bneedhamia/glockenspiel/MechanicalNotes.odp

## Mechanical notes for the Robotic Glockenspiel

Brad Needham

2015

## Lighted pushbutton order

Green

On

/Off

Red

Play

/Pause

Yellow

Skip

back

Yellow

Skip

forward

White

Shuffle

/Sequential

View from outside of box (pushbutton side)

## Lighted pushbutton / connector wiring

Button Common.

Blue/White

wire

Button Common.

Blue/White

wire

Button Normally-Open.

Blue

wire

Button Normally-Open.

Blue

wire

Back of Button

C

–

NO

NC

LED Cathode.

Orange/White

wire

+

LED Anode.

Orange

wire

LED Anode.

Orange

wire

4

3

2

1

LED Cathode.

Orange/White

wire

Connector pin numbers

Note: wire colors are from the 4-wire cable I used;

your wire colors/markings will be different.
