bneedhamia/glockenspiel/BillOfMaterials.ods

Bill Of Materials for Arduino-Controlled, 19-chime Glockenspiel
Count | Name | Supplier | Part Number | Cost each | Total | Url | Notes
1 | Arduino Mega 2650 R3 | Sparkfun | DEV-11061 | $45.95 | $45.95 | https://www.sparkfun.com/products/11061
1 | Wall Adapter Power Supply - 9VDC 650mA | Sparkfun | TOL-00298 | $5.95 | $5.95 | https://www.sparkfun.com/products/298 | 9v is important for solenoid power.
1 | Sparkfun Wifi Shield CC3000 | Sparkfun | DEV-12071 | $39.95 | $39.95 | https://www.sparkfun.com/products/12071 | Could use a MicroSD shield instead, if you don't want to use the network.
1 | Sparkfun TransmogriShield | Sparkfun | DEV-11469 | $14.95 | $14.95 | https://www.sparkfun.com/products/11469 | Interfaces between Mega and Shield
5 | Metal Pushbutton – Momentary, 16mm | Sparkfun | COM-11970, 11966,11968,11969 | $4.95 | $24.75 | https://www.sparkfun.com/products/11970 | Lighted pushbuttons: 1 green, 1 red, 2 yellow, 1 white. For start/stop, play/pause, forward 1 track, back 1 track, and shuffle tracks
3 | Breadboard - Full-Size (Bare) | Sparkfun | PRT-12615 | $5.95 | $17.85 | https://www.sparkfun.com/products/12615 | 2 for the solenoid circuit; 1 for the buttons circuit
1 | Hookup wire, solid, 22Awg, white | Sparkfun | PRT-08026 | $2.50 | $2.50 | https://www.sparkfun.com/products/8026 | Signal wires
1 | Hookup wire, solid, 22Awg, black | Sparkfun | PRT-08022 | $2.50 | $2.50 | https://www.sparkfun.com/products/8022 | Ground wires
1 | Hookup wire, solid, 22Awg, red | Sparkfun | PRT-08023 | $2.50 | $2.50 | https://www.sparkfun.com/products/8023 | Power wires
1 | Hookup wire, solid, 22Awg, yellow | Sparkfun | PRT-08024 | $2.50 | $2.50 | https://www.sparkfun.com/products/8024 | Solenoid power wires. I normally use green
19 | Solenoid, small, 5V, 4.5Ohm | Sparkfun | ZHO-0420S-05A4.5 | $4.95 | $94.05 | https://www.sparkfun.com/products/11015 | one per chime
3 | Break-away headers – straight, 40 pins | Sparkfun | PRT-00116 | $1.50 | $4.50 | https://www.sparkfun.com/products/116 | 2 x 38 for the solenoid connectors; 4 x 5 for the button connectors
1 | Standoffs Plastic (4-40; 3/8"; 10 pack) | Sparkfun | PRT-10461 | $2.95 | $2.95 | https://www.sparkfun.com/products/10461 | holds the circuit boards off the plywood box base.
3 | Metal EMT Conduit, 1/2", 10' | Lowes | 72711 | $2.48 | $7.44 | http://www.lowes.com/pd_72711-1792-101543_0__?productId=3129551 | The chimes. 3 is a generous estimate. You may be able to do it with only 2.
2 | dowel, round, poplar, 1/4" x 4' | Lowes | 19375 | $0.55 | $1.10 | http://www.lowes.com/pd_19375-261-436500_0__?Ntt=19375&UserSearch=19375&productId=3040764&rpp=16 | 1.75" pins x 2 per chime x 19 chimes
1 | cable ties, 8", 100 count | Lowes | 76329 | $7.15 | $7.15 | http://www.lowes.com/pd_76329-47120-SGY-CT23_0__?productId=50005730 | To tie down the solenoids and manage the solenoid wires. Need only about 25
5 | wood, pine, 3/4" x 1.5" x 4ft (1x2x4ft) | Lowes | 1204 | $2.48 | $12.40 | http://www.lowes.com/pd_1204-99899-83704_0__?productId=3602732&Ntt=wood+.75-in+x+1.5-in+x+4-ft&pl=1&facetInfo= | For the harp of the glockenspiel. 6Ft lengths might cause less waste
2 | wood, pine, 1" x 6" x 6ft | Lowes | ? | $2.48 | $4.96 | ? | sides of the box
2 | Birch Plywood (Common: 1/2-in x 2-ft x 4-ft; Actual: .45-in x 47.92-in x 23.92-in) | Lowes | 6200 | $11.97 | $23.94 | http://www.lowes.com/pd_6200-99899-1503304_0__?Ntt=6200 | Top and bottom of the box
1 | Birch Plywood (Common: 1/4-in x 2-ft x 4-ft; Actual: .17-in x 47.92-in x 23.92-in) | Lowes | 6197 | $8.36 | $8.36 | http://www.lowes.com/pd_6197-99899-1503104_0__?Ntt=6197 | Mounting boards for the circuit (Arduino, breadboards)
1 | Minwax 11.5-oz Fast-Drying Semi-Gloss Polyurethane Aerosol Spray | Lowes | 33055000 | $7.77 | $7.77 | http://www.lowes.com/pd_45873-24-33055000_0__?productId=3033786 | Any clear finish will do. The point is just to seal the wood to keep it clean.
1 | 1-1/2-in x 30-in Brass Cabinet Hinge (Piano hinge) | Lowes | 3887 | $8.97 | $8.97 | http://www.lowes.com/pd_3887-1277-838474_0__?Ntt=3887 | The main lid hinge – a piano hinge
1 | Brass Cabinet Cabinet Lid Support (Right) | Lowes | 311978 | $3.97 | $3.97 | http://www.lowes.com/pd_311978-1277-890418_0__?Ntt=311978 | Left lid spring hinge.
1 | Brass Cabinet Cabinet Lid Support (Left) | Lowes | 311978 | $3.97 | $3.97 | http://www.lowes.com/pd_311978-1277-890418_0__?Ntt=311978 | Right lid spring hinge
2 | Style Selections 96mm Center-to-Center Satin Nickel Bar Cabinet Pull | Lowes | 227442 | $6.47 | $12.94 | http://www.lowes.com/pd_227442-77652-S305-96/156-BNI_0__?Ntt=227442 | Side handles for carrying the box
2 | Waxman 4-Pack 1/2-in x 4-in Rectangle Adhesive-Backed Carpet Slider | Lowes | 54622 | $3.97 | $7.94 | http://www.lowes.com/pd_54622-255-4700595N_0__?Ntt=54622 | feet to keep the box from scratching whatever it's placed on.
1 | GE 2.8-oz Clear Silicone Window and Door Caulk | Lowes | 17417 | $3.98 | $3.98 | http://www.lowes.com/pd_17417-72643-GE500_0__?Ntt=17417 | Need only a tiny amount to put on the top of each solenoid. This reduces the loud "clank" sound when a chime is struck.
5 | 21 gauge Glue Applicator Syringe | Amazon |  | $1.69 | $8.45 | http://www.amazon.com/gp/product/B003O9I7U4 | Used to paint a small amount of silicone on the tip of each solenoid. You use one each time you do a gluing session.
1 | 10-Count #4-40 x 1-1/4-in Round-Head Standard (SAE) Machine Screws | Lowes | 62057 | $1.24 | $1.24 | http://www.lowes.com/pd_62057-37672-491278_0__?productId=3036648&Ntt=62057 | These hold the circuit boards to the plywood. Long enough to go through 1/8" plywood + 3/8" spacer + 1/2" plywood
1 | 0.375-in x 36-in Square Poplar Dowel | Lowes | 27594 | $1.04 | $1.04 | http://www.lowes.com/pd_27594-261-444504_0__?Ntt=27594 | thin wooden bar to keep the solenoid wires from touching the chimes. (I haven't added this, but it seems necessary)
4 | 0.5-in x 36-in Square Poplar Dowel | Lowes | 27692 | $1.77 | $7.08 | http://www.lowes.com/pd_27692-261-444506_0__?Ntt=27692 | Trim molding for the lid.
1 | 2-oz 16-Gauge 1-in Bright Steel Wire Brad | Lowes | 128124 | $1.30 | $1.30 | http://www.lowes.com/ProductDisplay?productId=3010680 | Need 12 to nail the box sides together, and about 20 to nail the edges to the lid. Bought a set of 50ct, but this item incorrectly says 2 ct.
20 | Diode, 1N4004, 400V, axial, Cut Tape | Digikey | 1N4004FSCT-ND | $0.17 | $3.34 |  | Need 19, but they come in lots of 10.
20 | Transistor, TIP120, TO-220 | Digikey | 497-2539-5-ND | $0.56 | $11.20
20 | Capacitor, 1000uF, 25V, radial | Digikey | 493-5913-1-ND | $0.51 | $10.28
1 | Micro SD card, 4GB | Sandisk |  | $7.00 | $7.00 | http://www.amazon.com/Sandisk-MicroSDHC-Memory-Card-Adapter/dp/B000WH6H1M/ | Use the cheapest reliable micro SD you can find. The Midi files and playlist consume almost no space.
1 | Waxman 4720095N Self-Stick Heavy Duty Felt Blanket Pads, 4-1/2-Inch by 6-Inch | Amazon | 4720095N | $4.49 | $4.49 | http://www.amazon.com/Waxman-4720095N-Self-Stick-Blanket-Oatmeal/dp/B0016L0M2I | Cut into 3/4" square pads for the chimes.
2 | heat shrink tubing, 1/4" x 4 ft | Amazon | B0053PYF62 | $4.99 | $9.98 | http://www.amazon.com/Install-Bay-Heat-Shrink-Tubing/dp/B0053PYF62 | Need one 4ft section for the 19x2 1" tubing for solenoids; part of another for buttons
1 | 50-ft, 24-gauge clear 2-conductor speaker wire | Radio Shack | 2781301 | $6.49 | $6.49 | http://www.radioshack.com/50-ft-24-gauge-clear-2-conductor-speaker-wire/2781301.html | About 2 feet per solenoid x 19 solenoids. Any 2-conductor wire will likely do.
1 | miscellaneous screws, bolts, nuts,, glue, solder |  |  | $20.00 | $20.00 |  | $20 is a rough estimate
1 | 100-ft 24/4 CAT 5E Riser Gray Data Cable | Lowes | 56917943 | $25.97 | $25.97 | http://www.lowes.com/pd_147965-295-56917943_0__?productId=3332656 | Need only about 8 feet of 4-conductor, non-shielded wire. This CAT-6 wire seemed the cheapest.
60 | 22-24 gauge female connector terminal | Digikey | WM2510-ND | $0.11 | $6.48 | http://www.digikey.com/product-search/en?pv7=3&k=0016020102 | Crimp connectors for the breadboard end of the solenoid wires and button wires. NOTE: you'll need a crimping tool, such as http://www.digikey.com/product-detail/en/0638111000/WM9999-ND/243789 or Sparkfun TOL-13193 ROHS
19 | CONN HOUSING 2POS .156 W/O RAMP | Digikey | WM1564-ND | $0.46 | $8.74 | http://www.digikey.com/product-detail/en/09-50-7021/WM1564-ND/1090442 | For connecting the solenoids to the breadboards
5 | CONN HOUSING 4POS .100 SINGLE | Digikey | WM2802-ND | $0.46 | $2.30 | http://www.digikey.com/product-search/en?KeyWords=50-57-9004 | For connecting the lighted push buttons to the breadboard
Grand Total |  |  |  |  | $511.17
