bneedhamia/glockenspiel/(list of files, drawings)

Other design files:
glockenspiel.fzz
