bneedhamia/glockenspiel/(commit log)

2014-12-11 Added draft bill of materials and circuit diagram
    [BillOfMaterials.ods, glockenspiel.fzz]
2014-12-11 Fixed name on license; added the glockenspiel Arduino player
    [glockenspiel.ino]
2014-12-15 switched to Sparkfun Wifi CC3000 Shield
2014-12-15 renamed to .cfg
    [glocken.cfg]
2014-12-16 typos in glocken.cfg
    [glocken.cfg]
2014-12-17 replced microSD shield with Wifi shield
    [BillOfMaterials.ods]
2014-12-20 made a few updates
    [BillOfMaterials.ods]
2014-12-22 Fixed #3, Fixed #4: corrected readNextLine to skip returns
    [glockenspiel.ino]
2014-12-22 Fixes #2: always play the delay/notes at end of track
    [glockenspiel.ino]
2014-12-23 added Angels We Have Heard on High; Deck the Hall; O Come All Ye Faithful
2014-12-28 added a few more items
    [BillOfMaterials.ods]
2015-01-01 Fixes #5: Added the aria source to all MIDI files; made all MIDI files 3 verses long; explained the pitch range in README
2015-01-02 revised the conduit and dowel numbers; added headers
    [BillOfMaterials.ods]
2015-01-05 Updated bill of materials from all the receipts so far
    [BillOfMaterials.ods]
2015-01-05 fixed a few typos in Bill of Materials
    [BillOfMaterials.ods]
2015-01-23 shortened scale.mid to be a quick circuit warmup
2015-01-25 Wired and tested the on/off lighted button; haven't added code to use it fully yet
2015-01-25 added glue syringes for silicone pads
    [BillOfMaterials.ods]
2015-02-08 added a test for the play/pause button; moved the scale warmup to setup() so it will not repeat
2015-02-08 Added test Skip Back button
    [glockenspiel.ino]
2015-02-09 The green light works now (blinks for error; lighted for running); the button is debounced, but does nothing yet.
    [glockenspiel.ino]
2015-02-09 On/Off button now works; stops after testing the chimes
2015-02-14 Added the pause button; fixed button-reading; pause not yet implemented
    [glockenspiel.ino]
2015-02-14 Back button is debounced and lights; doesn't skip back yet
    [glockenspiel.ino]
2015-03-02 added the last of the buttons; skip and shuffle buttons currently do nothing
    [glockenspiel.ino]
2015-03-04 Shuffle now takes effect on the start of the next track
2015-03-04 skip forward button now works; skip back doesn't do anything yet
    [glockenspiel.ino]
2015-03-06 all buttons are now implemented; added a #define for the miswired buttons
2015-03-08 added the button wiring
    [glockenspiel.fzz]
2015-03-08 finished the bill of materials
    [BillOfMaterials.ods]
2015-03-22 made button labels larger
2015-03-22 Noted the buttons and their functions
